UniversalScientificTechnologies/CLOCKMOT/PrjInfo.txt

[InfoShortDescription.en]
Universal clock machine

[InfoShortDescription.cs]
Univerzální hodinový stroj
  
[InfoLongDescription.en]
Equipment for autonomous time tracking of a astronomical object with astronomy teloscope. It could be commanded via IR Remote control. For stepper motors up to 45 V and 3 A.

[InfoLongDescription.cs]
Zařízení pro automatické sledování vyhledaného objektu dalekohledem. Zařízení může být ovládáno IR dálkovým ovladačem. Podporuje krokové motory do 45 V a 3 A. 
[End]
