UniversalScientificTechnologies/CLOCKMOT/DOC/SRC/CLOCKMOT01A_MAN.cs.docx

Hodinový stroj s dálkovým ovládáním

## 1.1. Návod

1. Zapněte napájení přístroje (sepnutí jističe na stěně).
2. Do cca 20 s je zařízení připraveno k provozu.
3. K ovládání hodinového stroje se využívá dálkový ovladač.

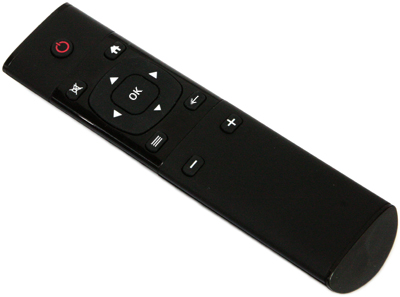
[picture p9: figure]

4. Zařízení má 4 režimy:
  a. Vypnuto – vypínací tlačítko
  b. 100% požadované rychlosti – tlačítko OK
  c. 80% požadované rychlosti – tlačítko se šipkou doleva
  d. 120% požadované rychlosti – tlačítko se šipkou doprava
5. Po ukončení činnosti stačí vypnout napájení (vypnutí jističe). Zařízení se následovně samo vypne.

## 1.2. Důležité informace pro uživatele

1. Po vypnutí jističe je možné jeho opětovné zapnutí až po 3 minutách.
2. Po dobu 1 minuty od zapnutí zařízení, není dovoleno zařízení vypínat (odpojovat od napájení – vypnutí jističe).
3. Dálkovým ovladačem je lepší mířit do prostoru (nesnažit se mířit přímo na zařízení).

CLOCKMOT01A / 2016-09-30 / jacho/ http://www.mlab.cz 1 / 1

CLOCKMOT01A MLAB
