UniversalScientificTechnologies/CLOCKMOT/DOC/SRC/img/20160908_195515.jpg

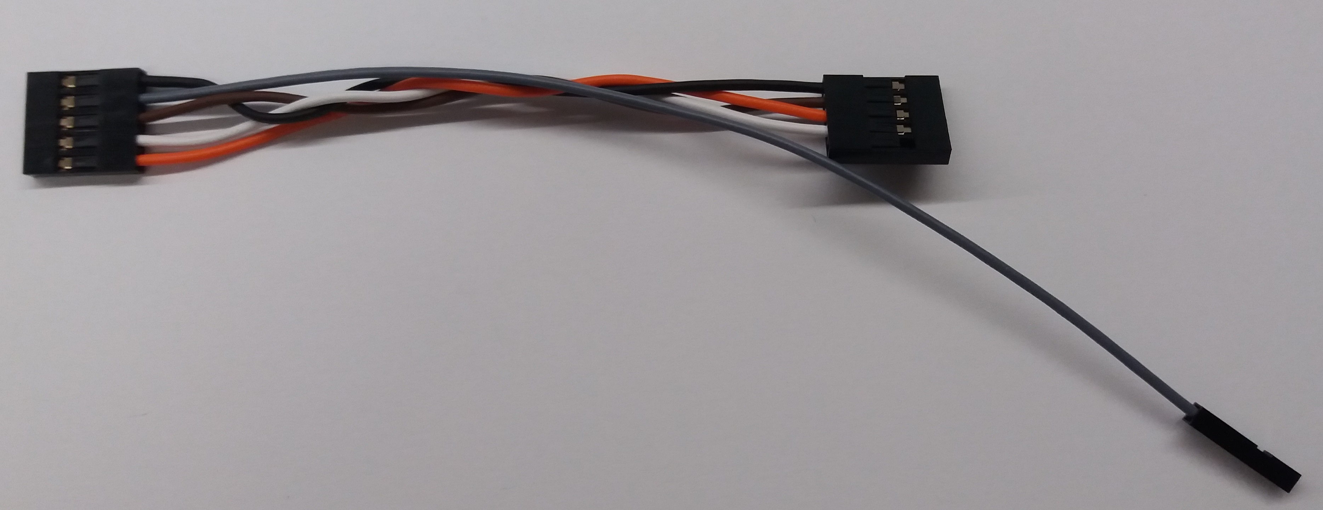
DOC/SRC/img/20160908_195515.jpg
