UniversalScientificTechnologies/CLOCKMOT/DOC/SRC/img/20160908_195536.jpg

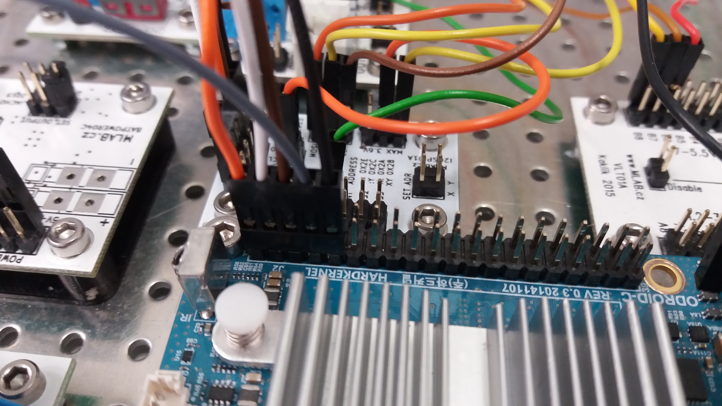
DOC/SRC/img/20160908_195536.jpg
