UniversalScientificTechnologies/CLOCKMOT/DOC/SRC/img/20160908_202540.jpg

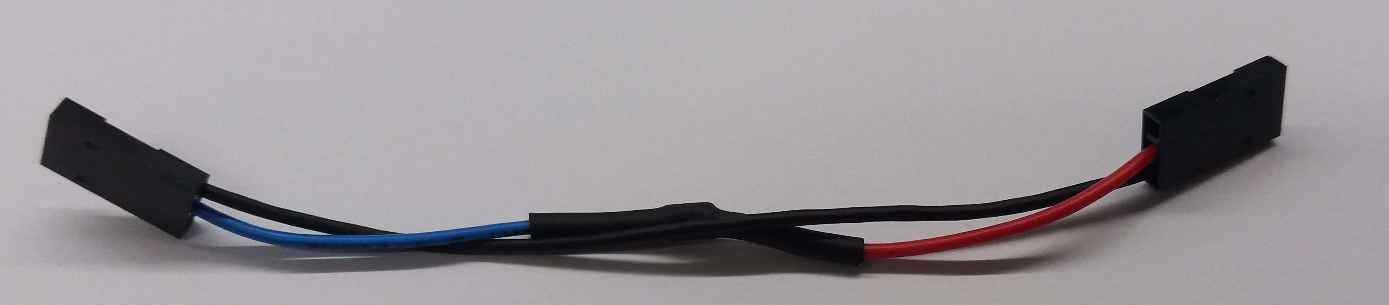
DOC/SRC/img/20160908_202540.jpg
