UniversalScientificTechnologies/CLOCKMOT/DOC/SRC/img/20160908_230000.jpg

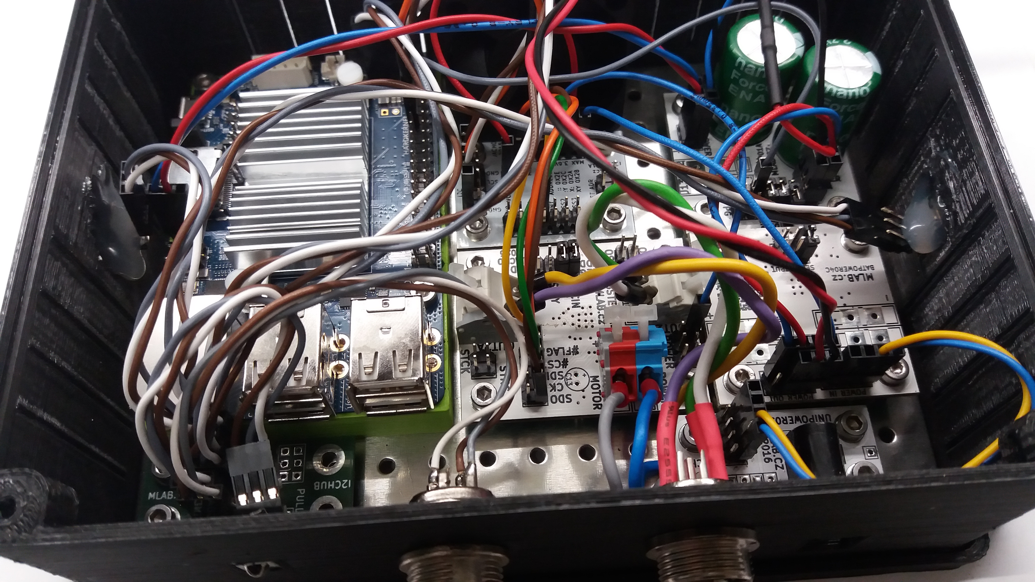
DOC/SRC/img/20160908_230000.jpg
