UniversalScientificTechnologies/CLOCKMOT/DOC/SRC/img/20160908_230006.jpg

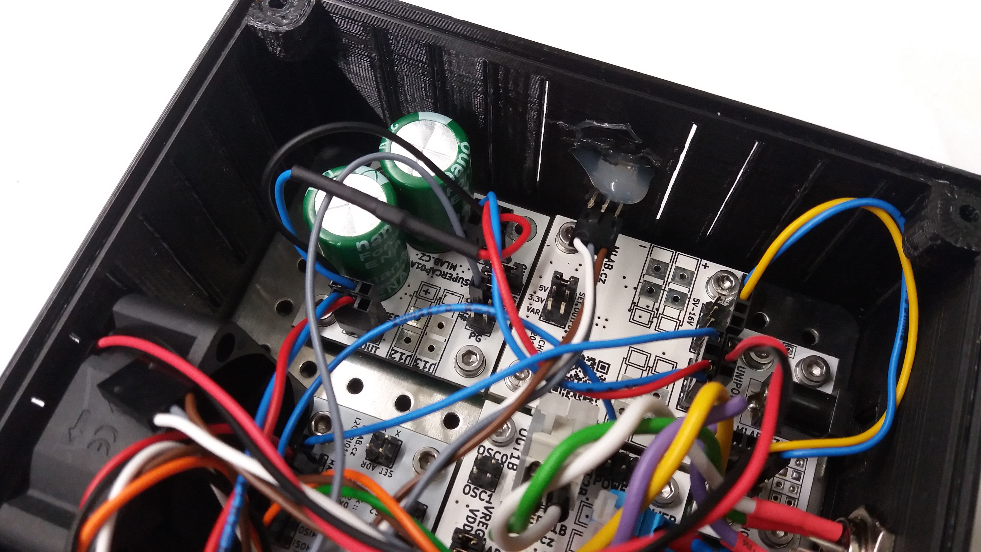
DOC/SRC/img/20160908_230006.jpg
