UniversalScientificTechnologies/CLOCKMOT/DOC/SRC/img/20160908_230011.jpg

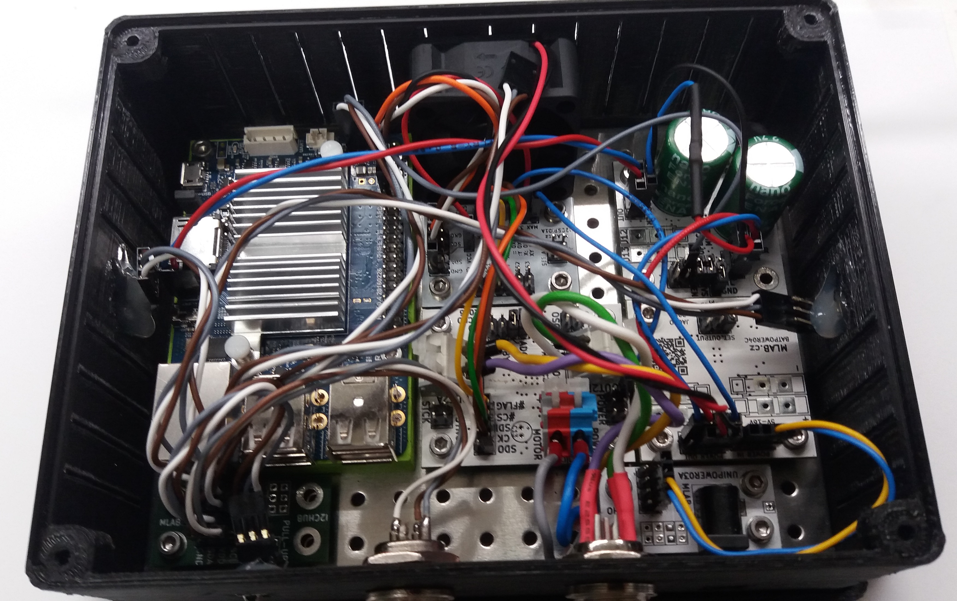
DOC/SRC/img/20160908_230011.jpg
