UniversalScientificTechnologies/CLOCKMOT/DOC/SRC/img/20160908_233036.jpg

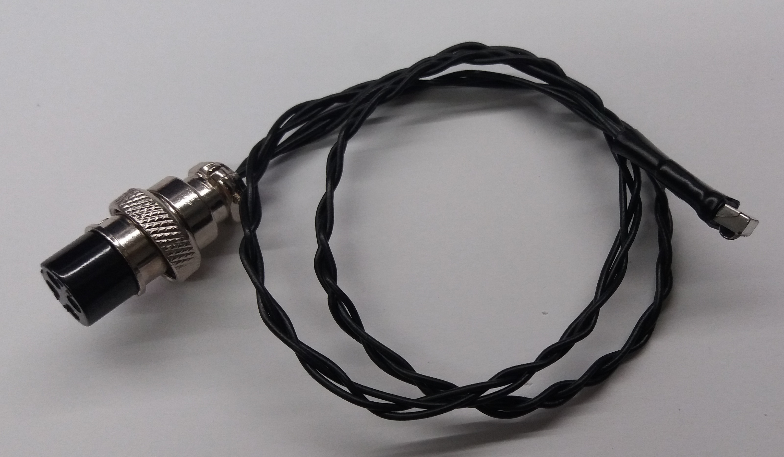
DOC/SRC/img/20160908_233036.jpg
