UniversalScientificTechnologies/CLOCKMOT/DOC/SRC/img/20160908_233330.jpg

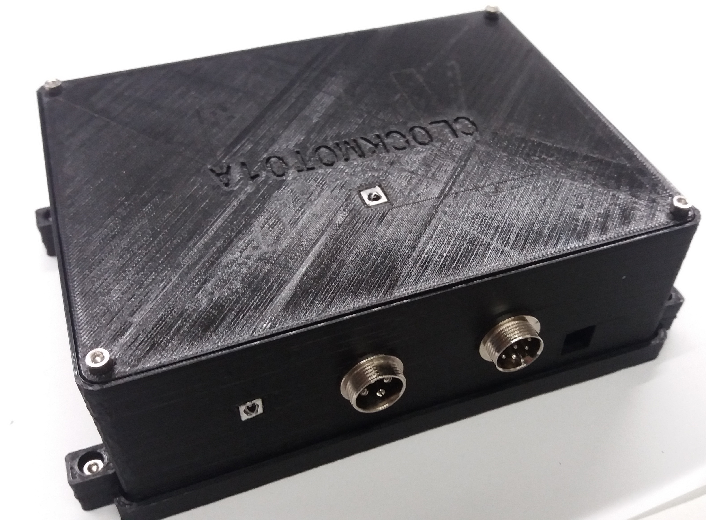
DOC/SRC/img/20160908_233330.jpg
