UniversalScientificTechnologies/CLOCKMOT/CAD/CLOCKMOT01A_BOX01A/AMF/CLOCKMOT01A_BOX01A_dno.stl

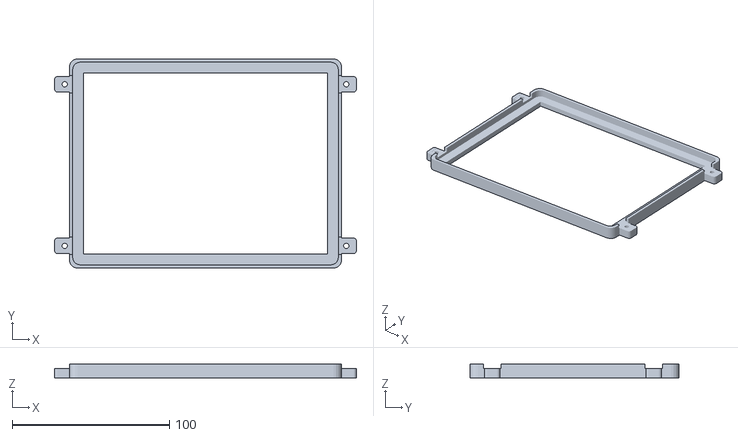
[picture p18: CAD file, 2016-09-07]
CAD/CLOCKMOT01A_BOX01A/AMF/CLOCKMOT01A_BOX01A_dno.stl
191.8 x 132.8 x 9.06
