UniversalScientificTechnologies/CLOCKMOT/CAD/CLOCKMOT01A_BOX01A/AMF/CLOCKMOT01A_BOX01A.stl

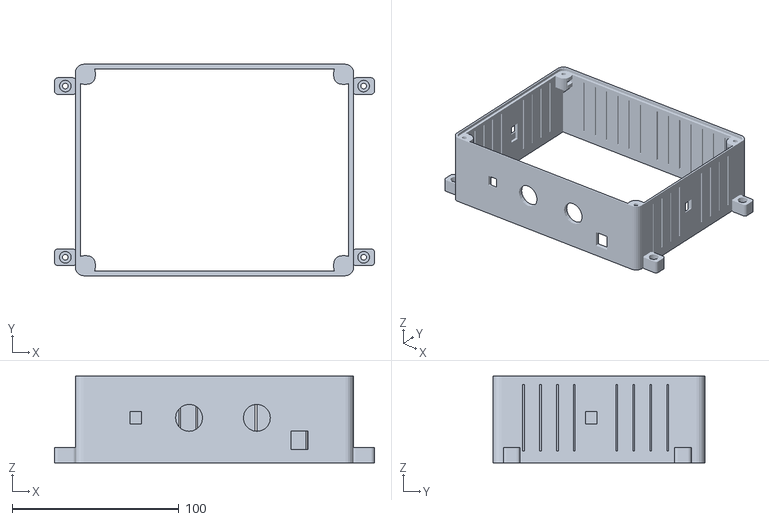
[picture p19: CAD file, 2016-09-05]
CAD/CLOCKMOT01A_BOX01A/AMF/CLOCKMOT01A_BOX01A.stl
191.8 x 126.8 x 52.0
