UniversalScientificTechnologies/CLOCKMOT/CAD/CLOCKMOT01A_BOX01A/AMF/CLOCKMOT01A_BOX01A_PLBASE_top.stl

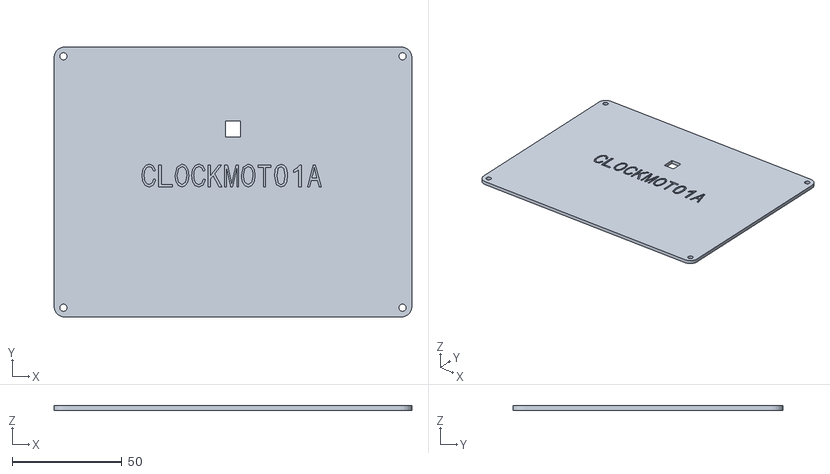
[picture p20: CAD file, 2016-09-05]
CAD/CLOCKMOT01A_BOX01A/AMF/CLOCKMOT01A_BOX01A_PLBASE_top.stl
163.4 x 123.4 x 2.10
