UniversalScientificTechnologies/CLOCKMOT/(list of files, cad)

Other CAD files:
CAD/CLOCKMOT01A_BOX01A/CAD/src/text/Letters.dxf
CAD/CLOCKMOT01A_BOX01A/CAD/assembly.scad
CAD/CLOCKMOT01A_BOX01A/CAD/print_data/CLOCKMOT01A_BOX01A.scad
CAD/CLOCKMOT01A_BOX01A/CAD/src/MLAB_logo.scad
CAD/CLOCKMOT01A_BOX01A/CAD/src/bocnice.scad
CAD/CLOCKMOT01A_BOX01A/CAD/src/dno.scad
CAD/CLOCKMOT01A_BOX01A/CAD/src/manufactury_conf.scad
CAD/CLOCKMOT01A_BOX01A/CAD/src/otvory.scad
CAD/CLOCKMOT01A_BOX01A/CAD/src/otvory_conf.scad
CAD/CLOCKMOT01A_BOX01A/CAD/src/plbase.scad
CAD/CLOCKMOT01A_BOX01A/CAD/src/produkt_logo.scad
CAD/CLOCKMOT01A_BOX01A/CAD/src/sloupek.scad
CAD/CLOCKMOT01A_BOX01A/CAD/src/spodni_kryt.scad
CAD/CLOCKMOT01A_BOX01A/CAD/src/text/Write.scad
