UniversalScientificTechnologies/CLOCKMOT/(commit log)

2016-03-11 nakresleno schema. Vygenerovan netlist a zalozen PCB.
2016-03-13 prvni cast pcb
2016-04-03 Pridani ddestovaciho kodu pro modul I2C232V01A.
2016-04-06 programovani testovaciho kodu pro prime pripojeni na SPI sbernici.
2016-04-11 oprava adresace SPI rozhraní na ODROID-C1.
2016-04-12 zmena nastaveni spi.
2016-04-17 zmena chovani na cyklicky test smeru otaceni motoru.
2016-06-21 zvysena odolnost kodu proti chybe prenosu na SPI.
    --Thisline, and those below, will be ignored--
    M CLOCKMOT.py
2016-07-03 WindGuage calibration logger
2016-07-26 oboustrany pcb
2016-08-12 Návrh PCB senzoru pro měreni delky impulzu.
2016-08-17 pokus o vytisk s 0.15mm vyskou vrstvy.
2016-08-23 zrcadlen osazovak spodni strany PCB.
2016-08-29 anemometr calibration software edit
2016-09-03 sjednoceni metod v SPI a I2C zpusobu ovladani.
2016-09-04 omezena maximalni rychlost motoru.
2016-09-04 Upravy ke zvyseni kvality testovani pri primem pripojeni SPI.
2016-09-05 uprava kodu pro ovladani pres I2C.
2016-09-05 zmena krabicky
    [CLOCKMOT01A_BOX01A.stl, CLOCKMOT01A_BOX01A_PLBASE_top.scad, CLOCKMOT01A_BOX01A_PLBASE_top.stl, CLOCKMOT01A_BOX01A_dno.scad, CLOCKMOT01A_BOX01A_dno.stl, assembly.scad, bocnice.scad, configuration.scad]
2016-09-07 zamezeni resetu bez pouziti prikazu float.
    [CLOCKMOT.py]
2016-09-08 zmena nastaveni napeti na motoru.
    --Thisy
    line, and those below, will be ignored--
    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
2016-09-13 Zalozeninoveho modulu pro differencni SPI.
2016-09-16 naimportovani netlistu do PCB editoru.
2016-09-17 pridani pauzy pred reset. uprava startovaciho skriptu tak, ze nemuze spustit vic procesu.
    [CLOCKMOT.py]
2016-09-17 snizena akcelarace motoru. zvyseny otacky na 37.5/min.
2016-09-17 zvetseni doby cekani na zastaveni motoru pred resetem.
    [CLOCKMOT.py]
2016-09-17 prodlouzena doba cekani na zastaveni motoru. k
2016-09-22 Doplneni popisku na PCB.
2016-10-19 doplneni textu oznacujiciho typ breakout frame.
2016-10-25 vytvoren breakoutframe pro Raspberry Pi3
2016-11-13 uprava pcb a henerovani vyrobnich dat
2016-11-30 pregenerovani vyrobnich STL podle zdrojoveho kodu.
2016-12-20 BP01B PCB upravy, WINDGAUGE02A upravy
